Tltlbo/ParkingLotSystem/README.md

# 🚗 스마트 주차 관리 시스템 (Smart Parking Management System)

현대 사회의 심화되는 주차난과 주차장 이용의 불편함을 해소하기 위해 기획된 **스마트 주차 관리 시스템**입니다. 초음파 센서 기반의 주차 공간 감지, 2중 차단기 인터록(Interlock) 제어, 비상 인터폰 시스템 및 실시간 주차 위치 추천 알고리즘을 통합하여 효율적이고 안전한 주차 환경을 제공합니다.

 

## 👥 팀원 및 역할 분담 (Team Roles)
- **박진성 (팀장):** 주차 자리 감지 구현, UART 송수신 파이프라인 및 인터폰 기능 구현
- **박정환:** 서보 모터(Servo Motor) 차단기 구동 및 PWM 정밀 제어
- **전명준:** UART 수신 파이프라인 최적화 및 I2C 1602 LCD 상태 표시 UI 구현
- **정승헌:** 초음파 센서(HC-SR04) 구역 감지 및 알고리즘 구현

---

## 🛠 하드웨어 구성 및 핀 맵 (Hardware Setup & Pinmap)

본 프로젝트는 3개의 별도 STM32 보드를 사용하여 모듈화된 시스템을 구축했습니다. 각 보드 간에는 UART(921600 bps) 고속 통신을 사용하며, 통신 안정성을 위해 **Common GND**로 연결되어 있습니다.

### 1. InfoMark 보드 (상태 표시 및 정보 안내)
사용자에게 주차장 상태와 최적 주차 위치를 시각적으로 제공하는 보드입니다.
- **I2C1 (디스플레이 통신):** `PB8` (SCL), `PB9` (SDA)
- **USART1 (보드 간 통신):** `PA10` (RX), `PA9` (TX)
- **USART2 (디버그 통신):** `PA2` (TX), `PA3` (RX)

infomark_board_1788313444978

### 2. ParkingDetect 보드 (주차 자리 감지 및 메인 오디오 제어)
각 주차면의 상태를 아날로그 센서로 읽어들이고, 비상 인터폰용 오디오 입출력을 담당합니다.
- **ADC (주차면 아날로그 센서 입력):** `PA0`, `PA1`, `PA4`, `PA6`, `PA7`, `PB0`, `PC0`, `PC1`, `PC2`, `PC4`
- **I2S2 (INMP441 마이크 모듈):** `PB10` (CK/SCK), `PB12` (WS), `PC3` (SD)
- **PWM (LM386 오디오 앰프 출력):** `PA8` (TIM1_CH1)
- **USART1 (보드 간 통신):** `PA10` (RX), `PA9` (TX)

parkingdetect_board_1788313455689

### 3. plMachine 보드 (차단기 구동 및 출입구 초음파 감지)
주차장 진출입구의 통행량을 관리하고 차단기 모터를 제어합니다.
- **HC-SR04 초음파 센서 (입출차 감지):**
  - **TRIG (출력):** `PA6`, `PA7`, `PA8`, `PA9`
  - **ECHO (입력):** `PB10`, `PB13`, `PB14`, `PB15`
- **서보 모터 (차단기 제어):**
  - 입차 차단기 PWM: `PB8` (TIM4_CH3)
  - 출차 차단기 PWM: `PB9` (TIM4_CH4)

plmachine_board_1788313465761
---

## ✨ 주요 기능 (Key Features)

### 1. 단방향 2중 차단기 상호 인터록(Interlock) 제어
1차로와 같은 좁은 진출입로에서 발생할 수 있는 교행 사고를 물리적으로 원천 차단합니다.
- 입차 차량 진입 감지 시, 반대편 출차 차단기를 소프트웨어적으로 **강제 잠금(Lock)** 처리합니다.
- 차량이 완전히 통과하여 센서 점유가 해제된 후 정상 대기 모드로 복귀합니다.

### 2. 비상 인터폰 및 입출차 원격 제어
차단기 미인식 또는 돌발 상황 발생 시 관리실과 직접 소통할 수 있는 안전 메커니즘입니다.
- **양방향 통신:** 운전자가 비상 버튼을 누르면 INMP441(마이크)과 LM386(스피커)을 통해 관리실과 음성 교신을 진행합니다.
- **원격 해제:** 상황 확인 후 관리자 측에서 수동으로 인터록을 해제하고 차단기를 개방할 수 있습니다.

### 3. 실시간 주차 위치 추천 알고리즘
주차장 내 각 구역의 센싱 데이터를 바탕으로 운전자에게 최적의 주차 공간을 안내합니다.
- **실시간 센싱:** 10개 이상의 주차면에 배치된 센서가 주차 여부를 지속적으로 파악합니다.
- **최적 자리 계산:** 출입구 도보 5초 이내, 최단 거리 등의 조건부 우선순위에 따라 최우선 추천석을 결정합니다.
- **LED 표출:** 계산된 추천 구역(예: `[ B-01 ]`)을 I2C 패킷으로 전송하여 즉각 화면에 업데이트합니다.

---

## 기능 별 테스트 상황

| 정상 입출차 | 인터락 상황 |
| :---: | :---: |
|  |  |
| **마이크 및 차단봉 임의 조작** | **주차 감지** |
|  | 

## 🚀 트러블슈팅 (Troubleshooting)

개발 과정에서 마주친 주요 하드웨어 및 소프트웨어적 한계를 다음과 같이 극복했습니다. 상세한 과정은 [`troubleshooting.md`](troubleshooting.md)에서 확인할 수 있습니다.

1. **초음파 센서 간 상호 간섭 (Crosstalk) 해결**
   - **문제:** 여러 센서가 동시에 초음파를 발사하여 엉뚱한 거리(0cm 또는 300cm)로 값이 튀는 현상 발생.
   - **해결:** 데이터시트를 분석하여 트리거 주기를 기존 20ms에서 **60ms로 연장**하고, 센서들을 **순차적(폴링 방식)으로 측정**하도록 로직을 변경하여 잔여 음파로 인한 간섭을 제거했습니다.

2. **스피커 출력 노이즈 및 음질 개선**
   - **문제:** 마이크 오디오를 PWM으로 스피커에 직결 시 심한 노이즈 발생 및 스피커 코일 과부하 위험.
   - **해결:** 스피커 출력단에 **RC 로우패스 필터(Low-Pass Filter)**와 **커플링 커패시터(Coupling Capacitor)** 회로를 추가하여 고주파 노이즈를 걸러내고 DC 성분을 차단했습니다.

3. **오디오 지연 및 DMA 버퍼 오버런 (Baud Rate 병목)**
   - **문제:** 초당 32,000 Byte의 오디오 데이터를 115200 bps(초당 약 11,520 Byte)로 전송하려다 통신 지연 및 보드 멈춤 현상 발생.
   - **해결:** UART 통신 속도를 **921600 bps**로 대폭 상향하여 광활한 대역폭을 확보, 지연 없는 실시간 오디오 스트리밍을 구현했습니다.

4. **단일 UART 선에서 데이터 혼선 방지 (패킷 프로토콜 설계)**
   - **문제:** 하나의 통신 선으로 '텍스트(주차 상태)'와 '바이너리(오디오)' 데이터를 섞어서 보낼 때의 파싱 오류.
   - **해결:** 오디오 패킷 헤더로 우연히 발생할 확률이 극히 희박한 **`0xAA, 0x55`**를 채택했습니다. 주차 데이터는 전체 복구를 위한 `$PARK`(풀 스냅샷)와 즉각적인 반응을 위한 `$EVENT`(이벤트 알림) 패킷으로 분리하여 효율을 극대화했습니다.

---

## 🔮 향후 발전 방향 (Future Work)
- **비전 AI 연동:** 카메라 기반 차량 번호판 인식을 도입하여 비차량 오탐지 방지 및 자동 입출차 시스템 구현.
- **센서 퓨전 & 정교화:** 마이크 노이즈 필터링 고도화 및 다중 센서 값 융합을 통한 주차 감지 정확도 향상.
- **사용자 경험(UX) 개선:** 게이트 상태 및 경고 알림용 부저/인디케이터 추가 연동, 부드러운 모터 속도 제어(S-curve) 도입.
