Tltlbo/ParkingLotSystem/스마트 주차 차단기 발표 자료.pdf

# 스마트 주차 관리 시스템

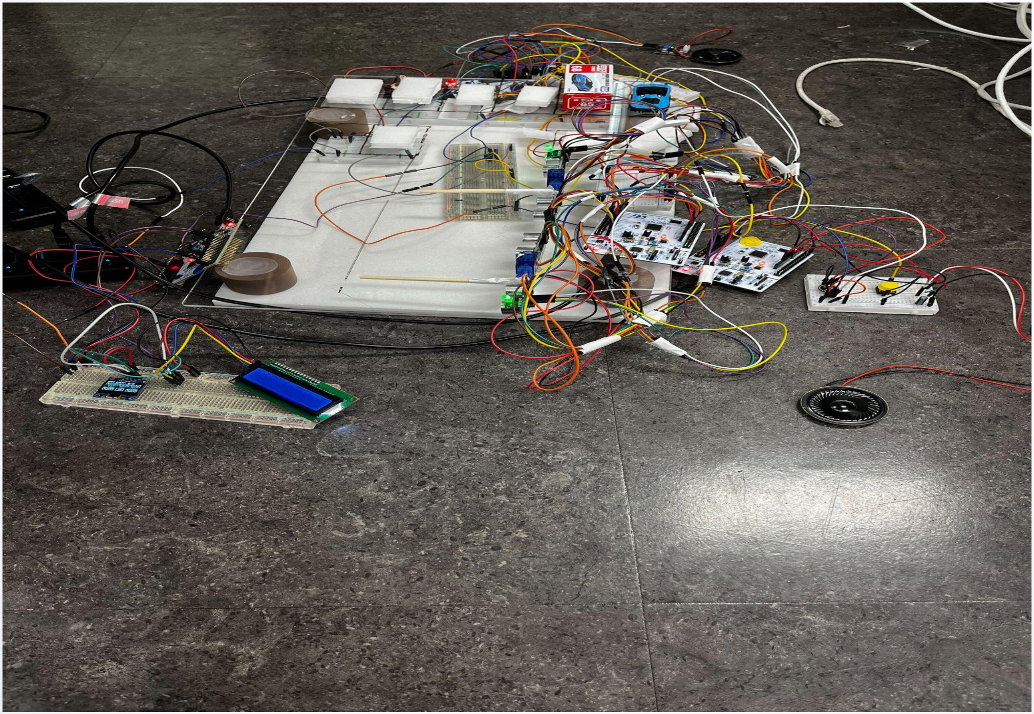
[picture p1: figure]

# 팀장 : 박진성 팀원 : 박정환 전명준 정승헌

# 주차장의 수요

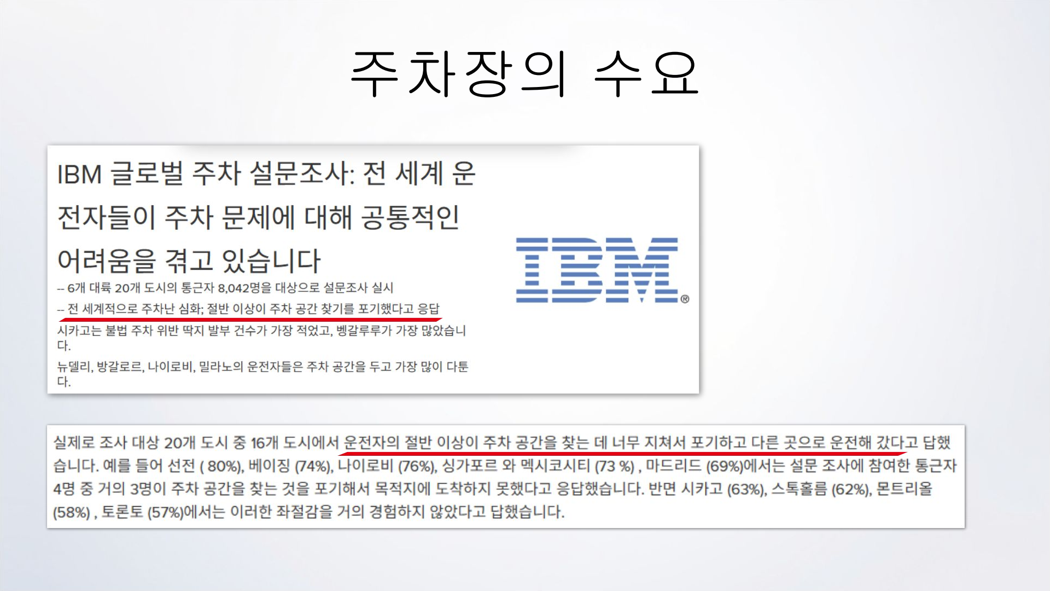
[picture p2: page 2]

# 기존 주차장들의 문제점

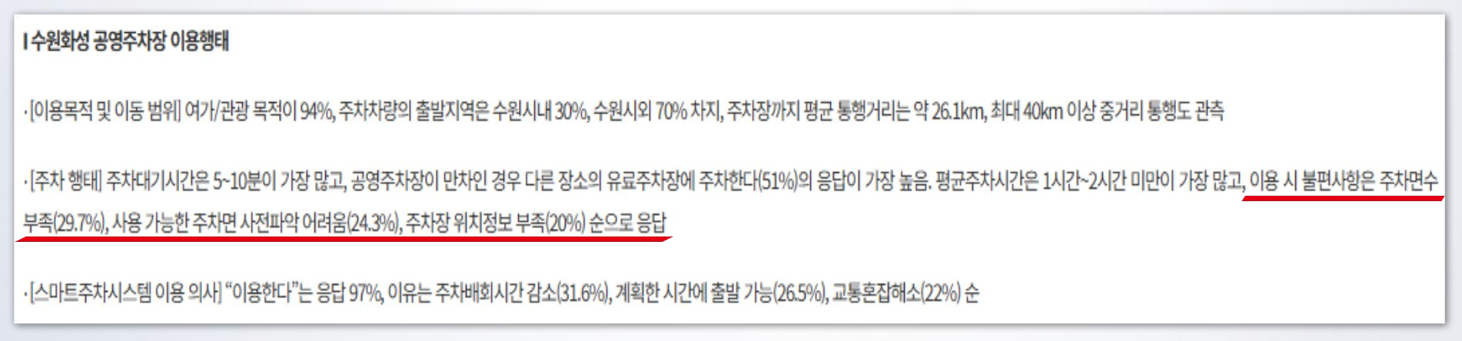
[picture p3: figure]

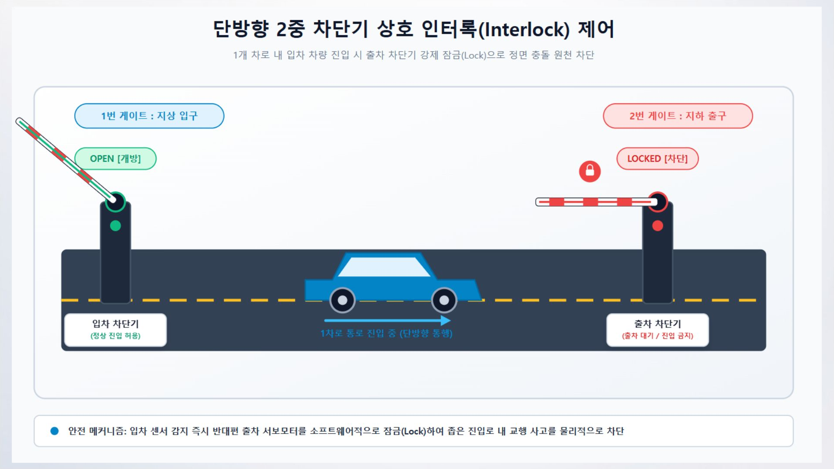
[picture p4: page 9]
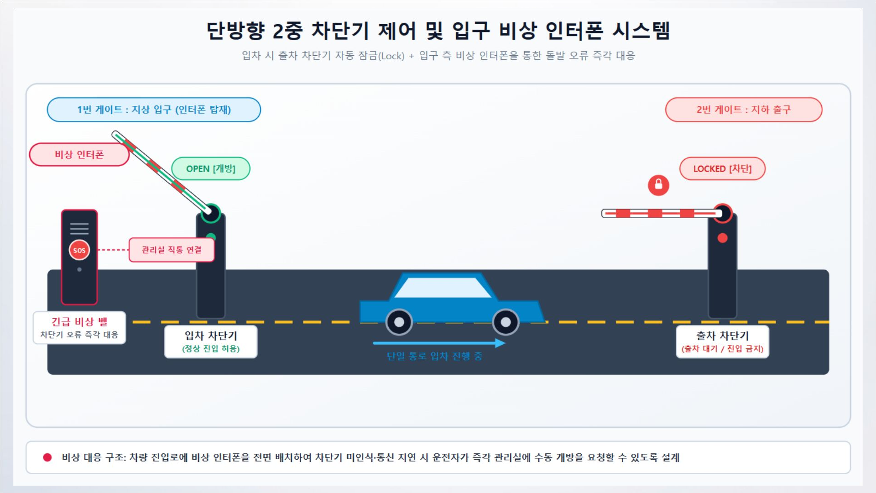
[picture p5: page 10]

# Team Role [팀원 역할

분담]

# 정승헌 : 초음파 센서 구역 감지 구현

# 박정환 : 서보 모터 차단기 구동 및 PWM 제어

# 전명준 : UART 수신 파이프라인 및 I2C 1602 LCD 상태 표시

# 박진성 : 주차 자리 감지 구현, UART 송신, 수신 및 인터폰

구현

# Servo Motor

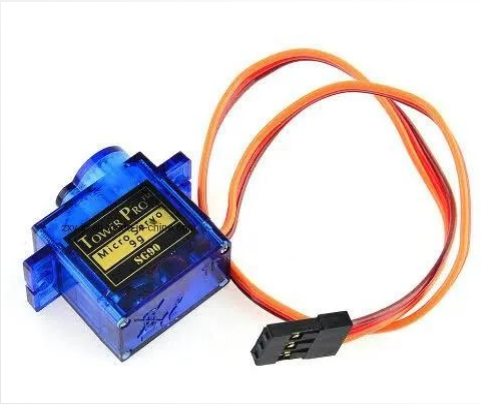
[picture p6: figure]

# - PWM

# 초음파 센서

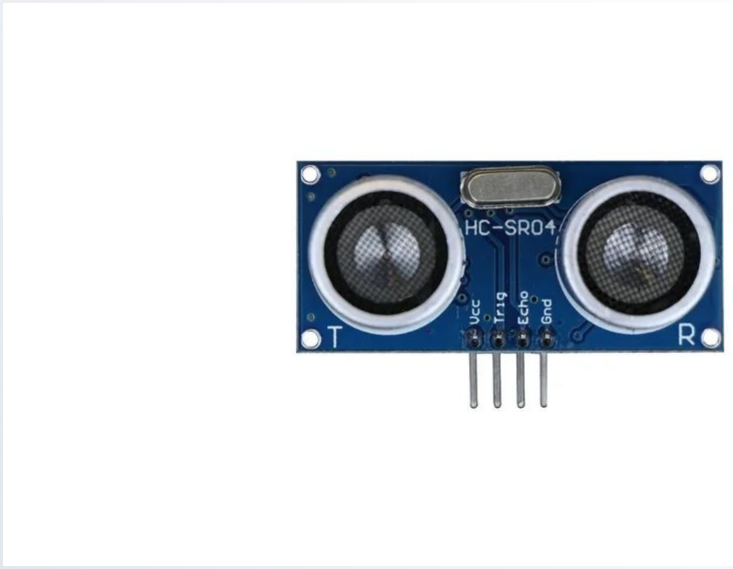
[picture p7: figure]

# - Echo

# - Trig

# INMP441 (마이크 모듈)

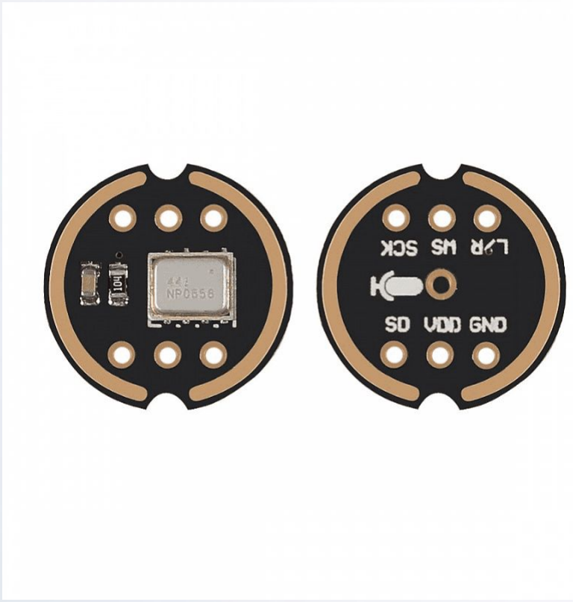
[picture p8: figure]

- I2S

# - SCK

- WS
- L/R
- SD

# - PCM

# LM386 (오디오 앰프 모듈)

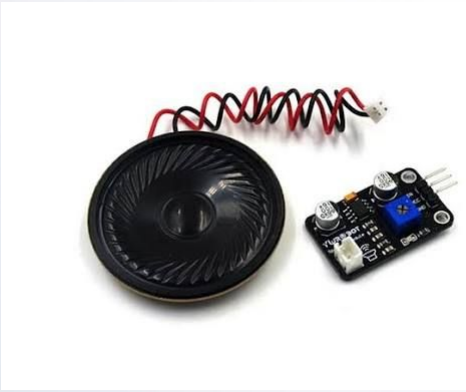
[picture p9: figure]

# - PWM

# 차단기 기능 모듈 배치

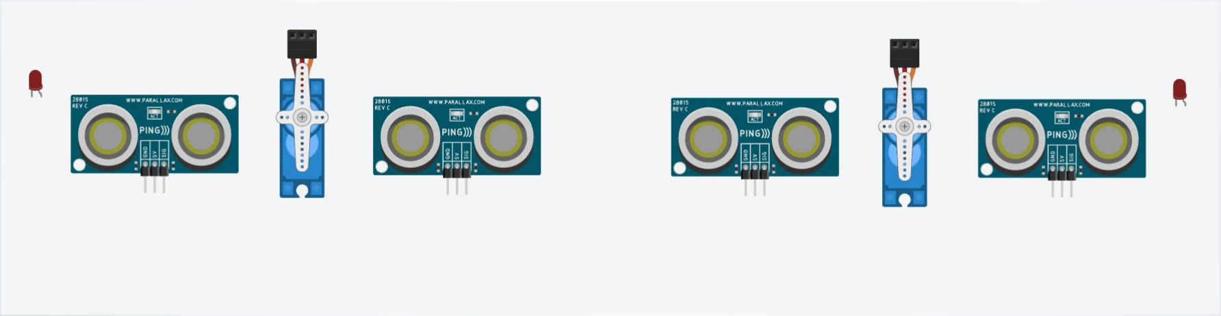
[picture p10: figure]

# 스마트 파킹 4개 초음파 센서 (HC-SR04) 주차차단기 제어 흐름도

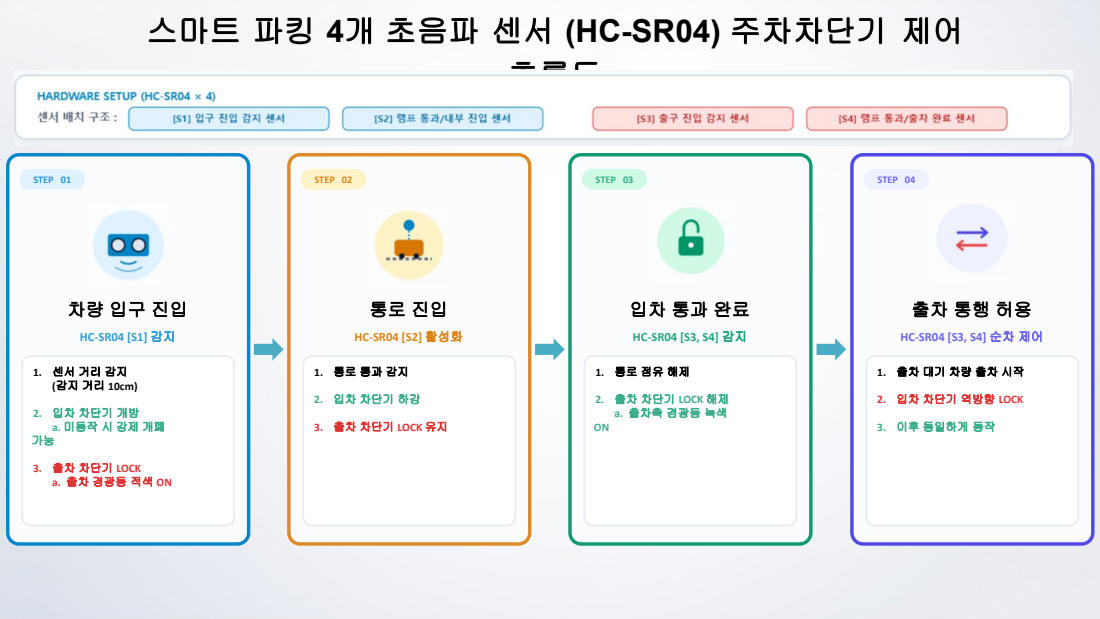
[picture p11: page 17]
STEP 01; STEP 04; STEP 02; HC-SR04 [S2] 활성화; STEP 03

2. 입차 차단기 하강

2. 출차 차단기 LOCK 해제
a. 출차측 경광등 녹색

2. 입차 차단기 역방향 LOCK

2. 입차 차단기 개방
a. 미동작 시 강제 개폐

3. 출차 차단기 LOCK 유지

3. 이후 동일하게 동작

3. 출차 차단기 LOCK
a. 출차 경광등 적색 ON

# 주차 감지 기능 모듈 배치

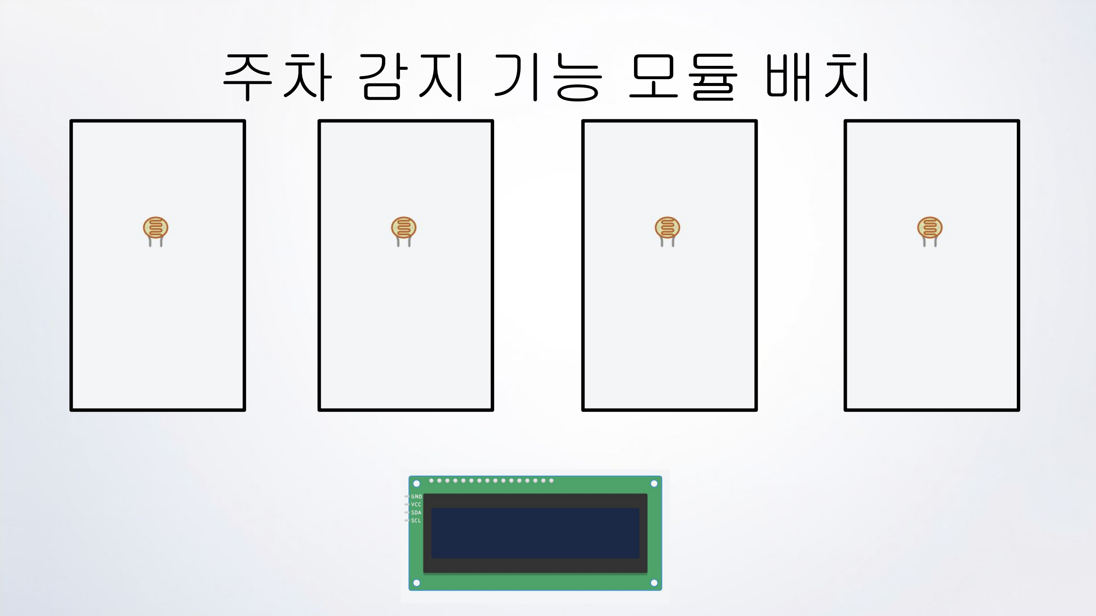
[picture p12: page 18]

# 주차 위치 추천 알고리즘 흐름도

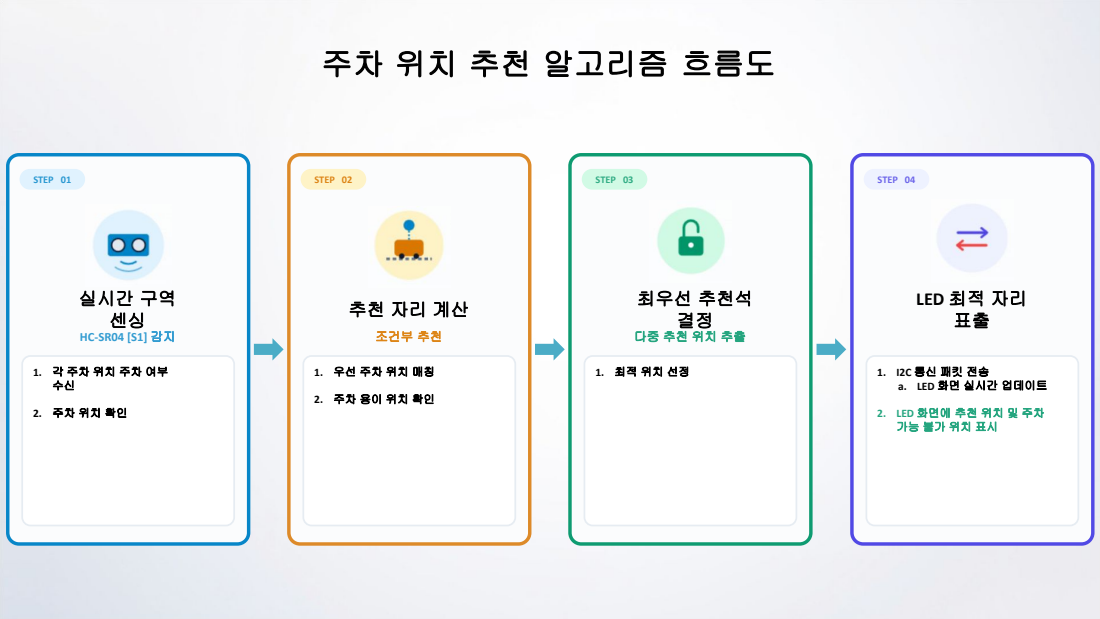
[picture p13: page 19]
STEP 01; 실시간 구역 센싱; STEP 04; STEP 02; 조건부 추천; STEP 03; 최우선 추천석 결정

LED 최적 자리

a. LED 화면 실시간 업데이트

2. LED 화면에 추천 위치 및 주차

# 비상 인터폰 모듈 배치

입차 측 | 출차 측

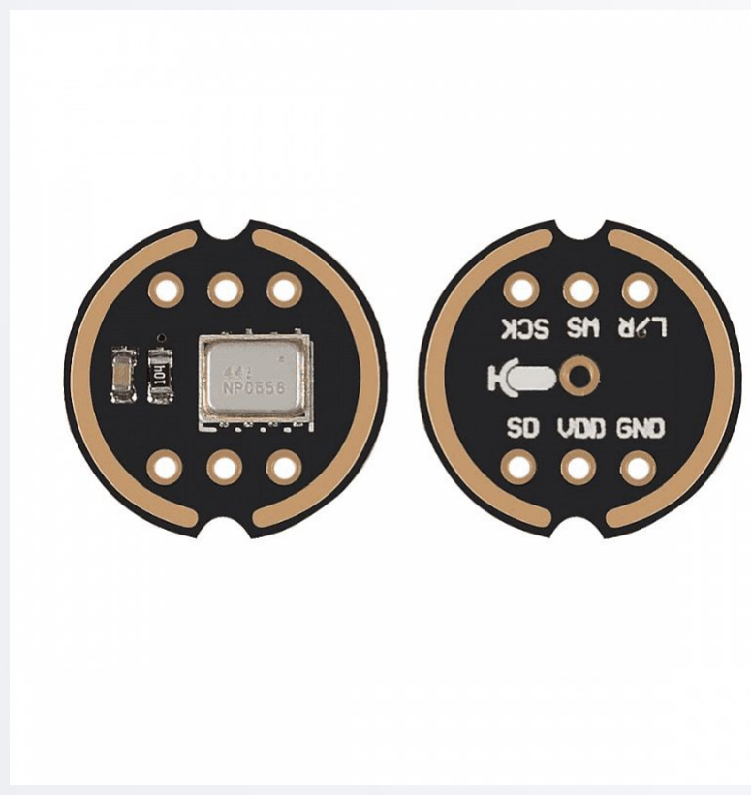
[picture p14: figure]
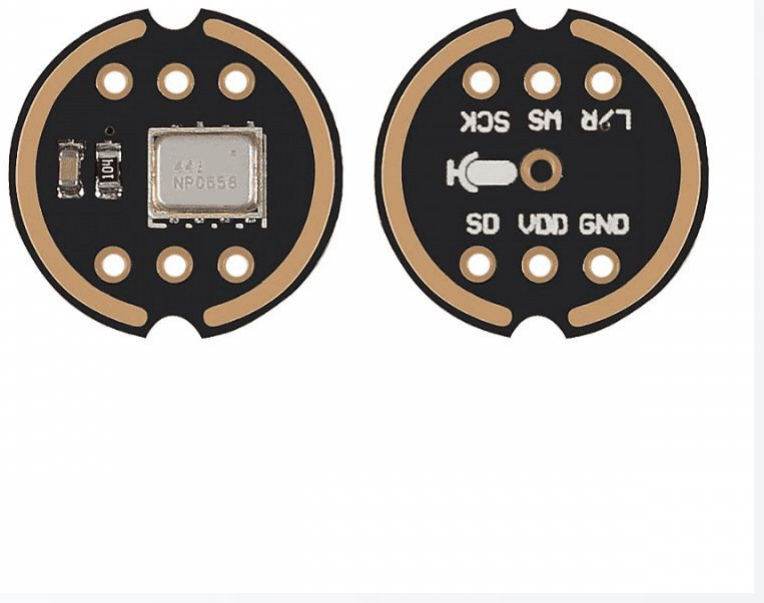
[picture p15: figure]
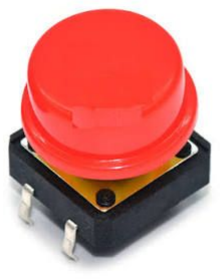
[picture p16: figure]
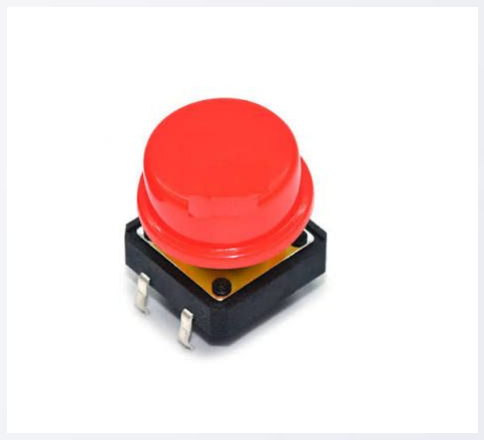
[picture p17: figure]
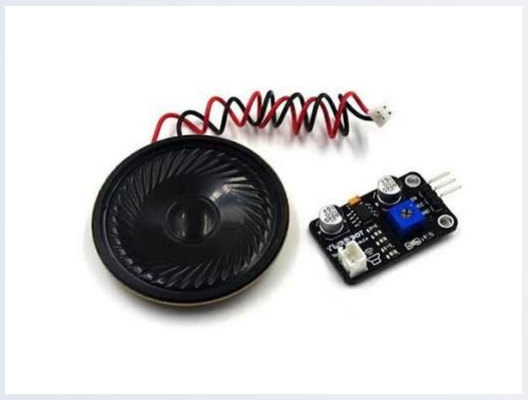
[picture p18: figure]
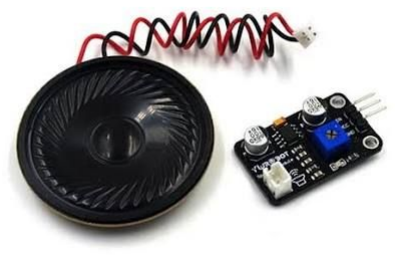
[picture p19: figure]

# 스마트 파킹 비상 인터폰 및 입출차 LOCK 해제 알고리즘

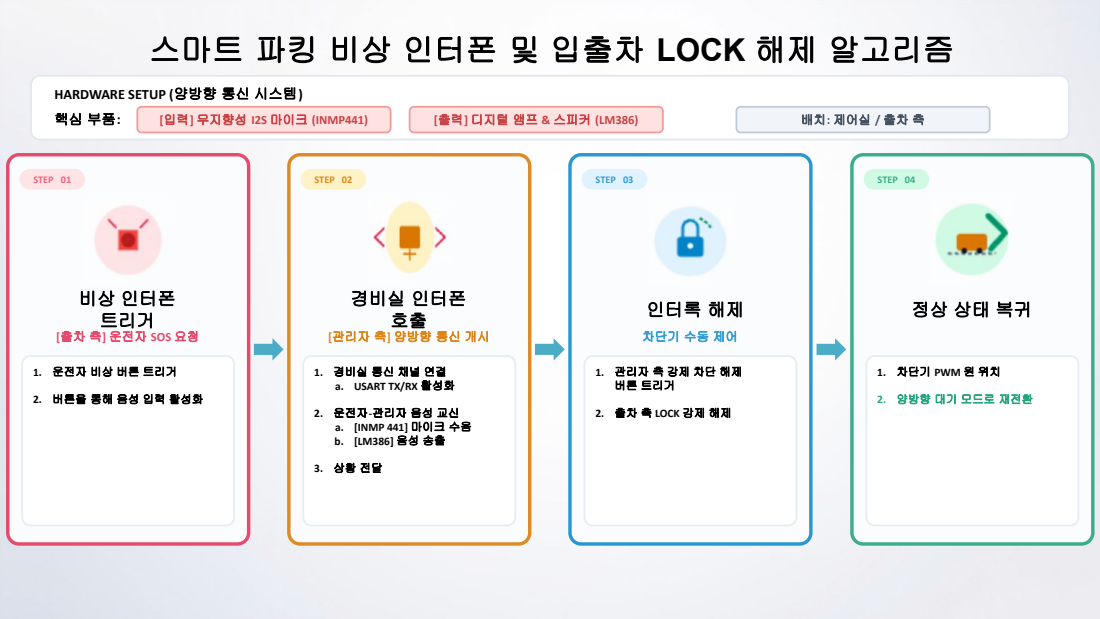
[picture p20: page 21]
STEP 01; 비상 인터폰 트리거; STEP 04; STEP 02; 경비실 인터폰 호출; STEP 03; 인터록 해제; [입력] 무지향성 I2S 마이크 (INMP441); [출력] 디지털 앰프 & 스피커 (LM386); 배치: 제어실 / 출차 측

HARDWARE SETUP (양방향 통신 시스템)

[출차 측] 운전자 SOS 요청

[관리자 측] 양방향 통신 개시

차단기 수동 제어

1. 운전자 비상 버튼 트리거

1. 경비실 통신 채널 연결
a. USART TX/RX 활성화

1. 관리자 측 강제 차단 해제
버튼 트리거

1. 차단기 PWM 원 위치

2. 버튼을 통해 음성 입력 활성화

2. 양방향 대기 모드로 재전환

2. 운전자-관리자 음성 교신
a. [INMP 441] 마이크 수음

2. 출차 측 LOCK 강제 해제

# 차단기 정상 동작

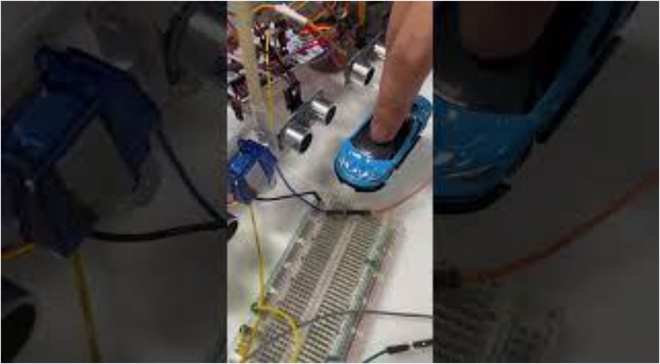
[picture p21: figure]

# 인터락 상황

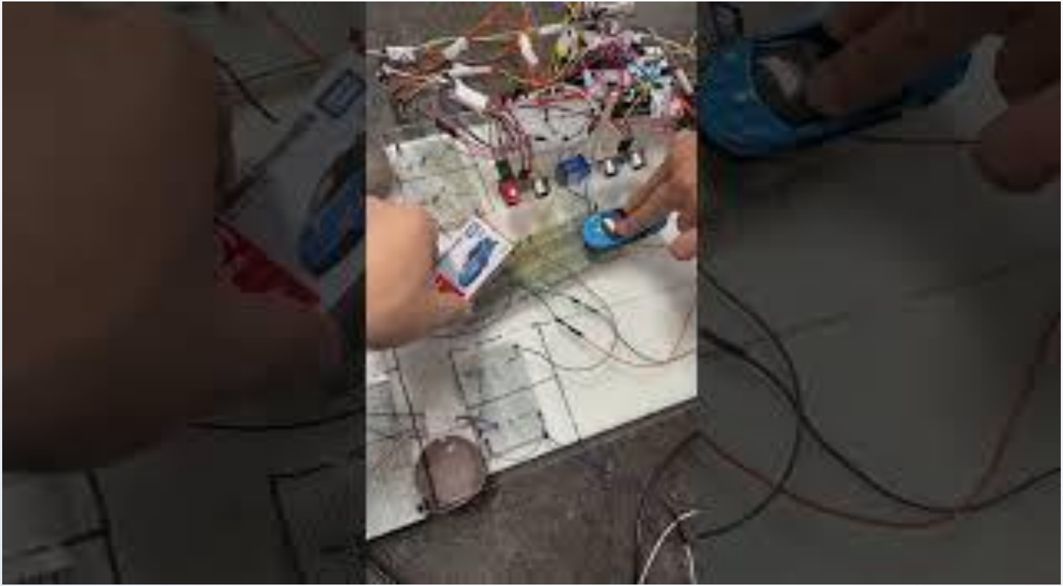
[picture p22: figure]

# 차단기 임의 개방

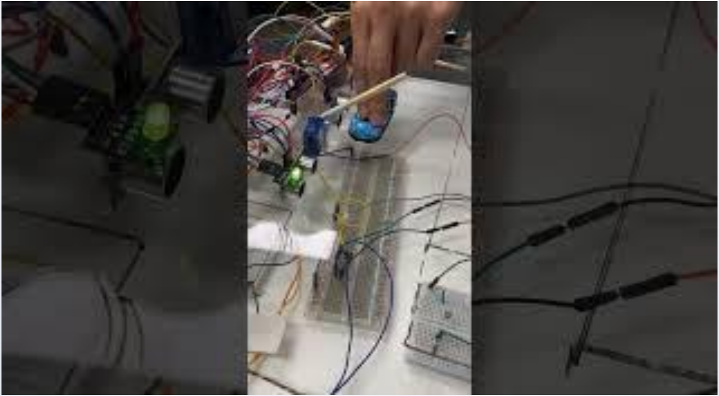
[picture p23: figure]

# 마이크 동작 및 차단기

동작

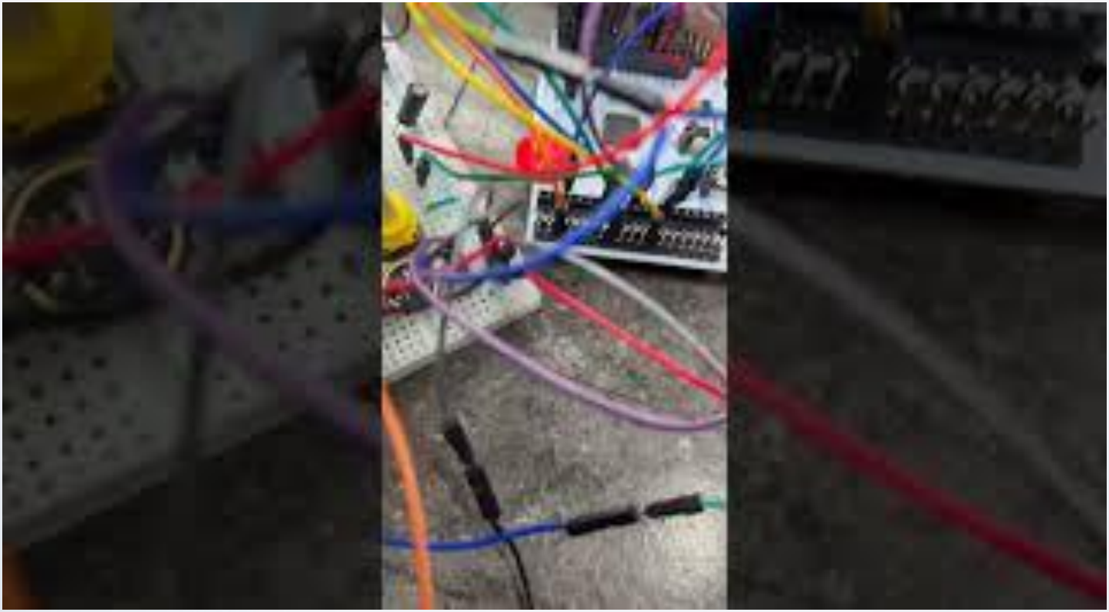
[picture p24: figure]

# 주차 감지

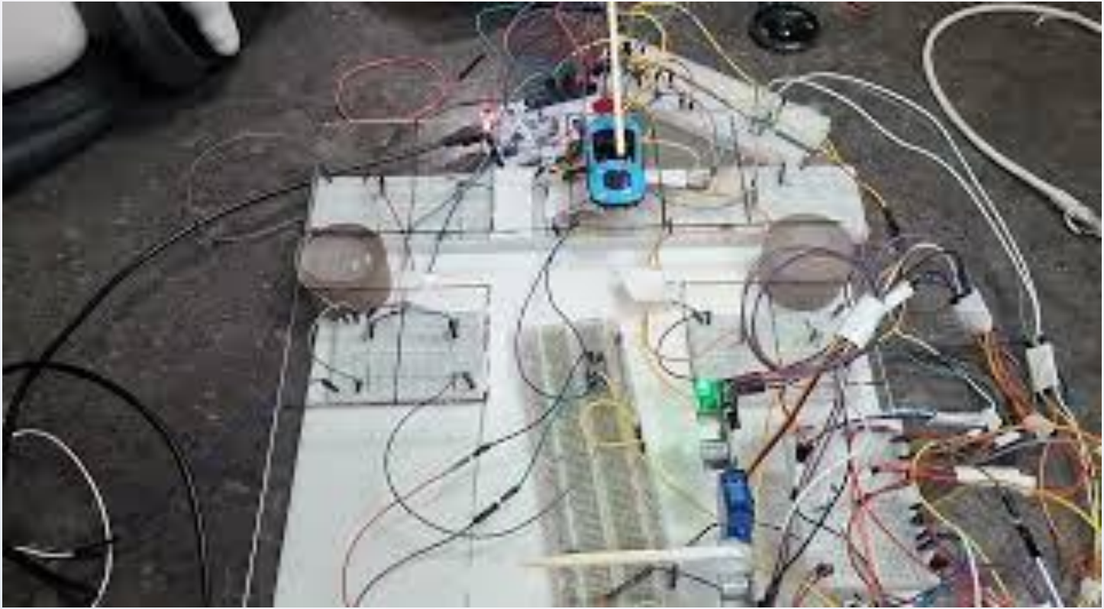
[picture p25: figure]

# 전체 동작

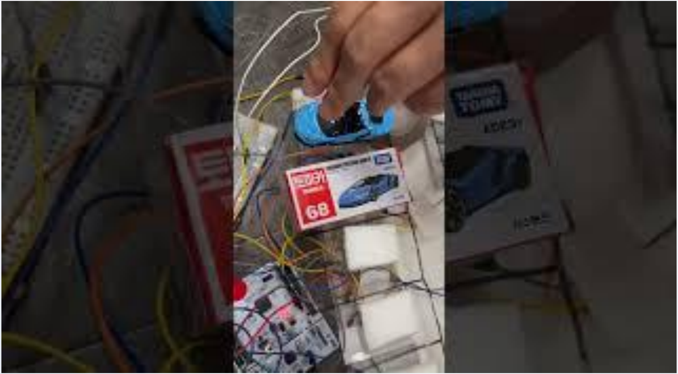
[picture p26: figure]

# 트러블 슈팅 [ 초음파 센서 인식 오류 ]

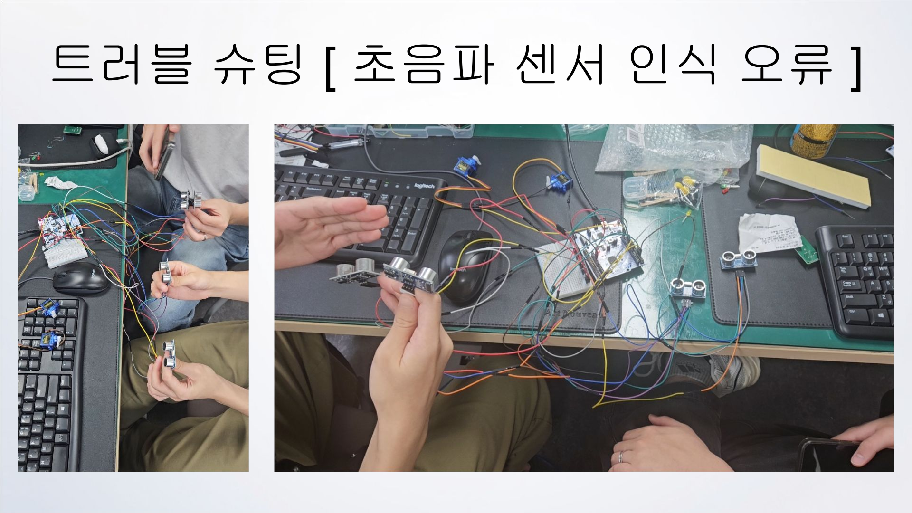
[picture p27: page 28]

# 센서 간 상호 간섭(Crosstalk)

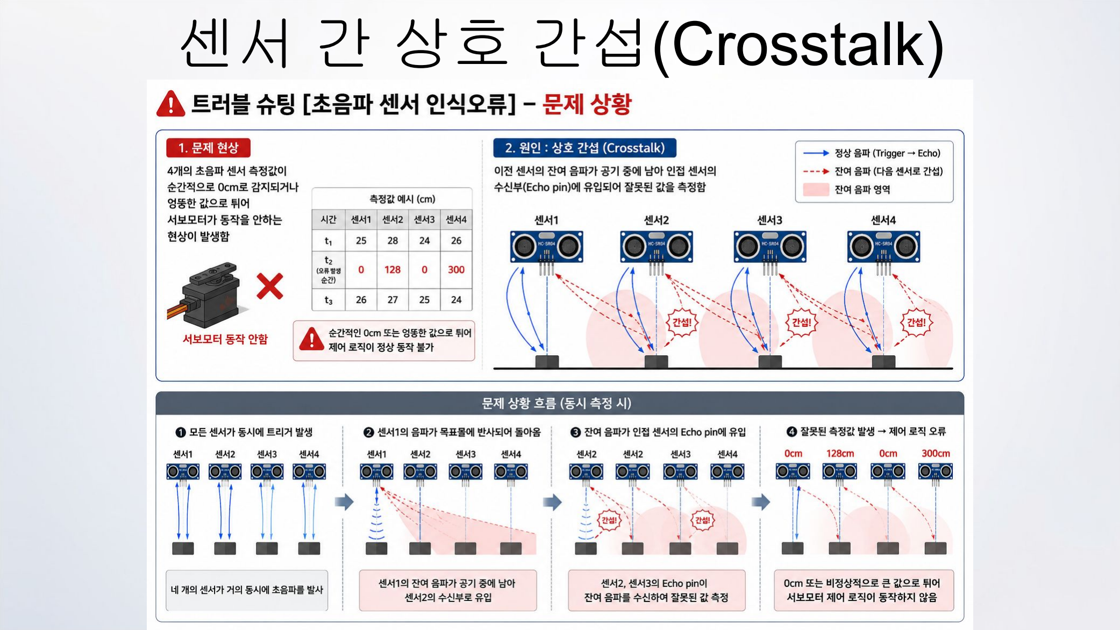
[picture p28: page 29]

# 상호 간섭 오류 개선

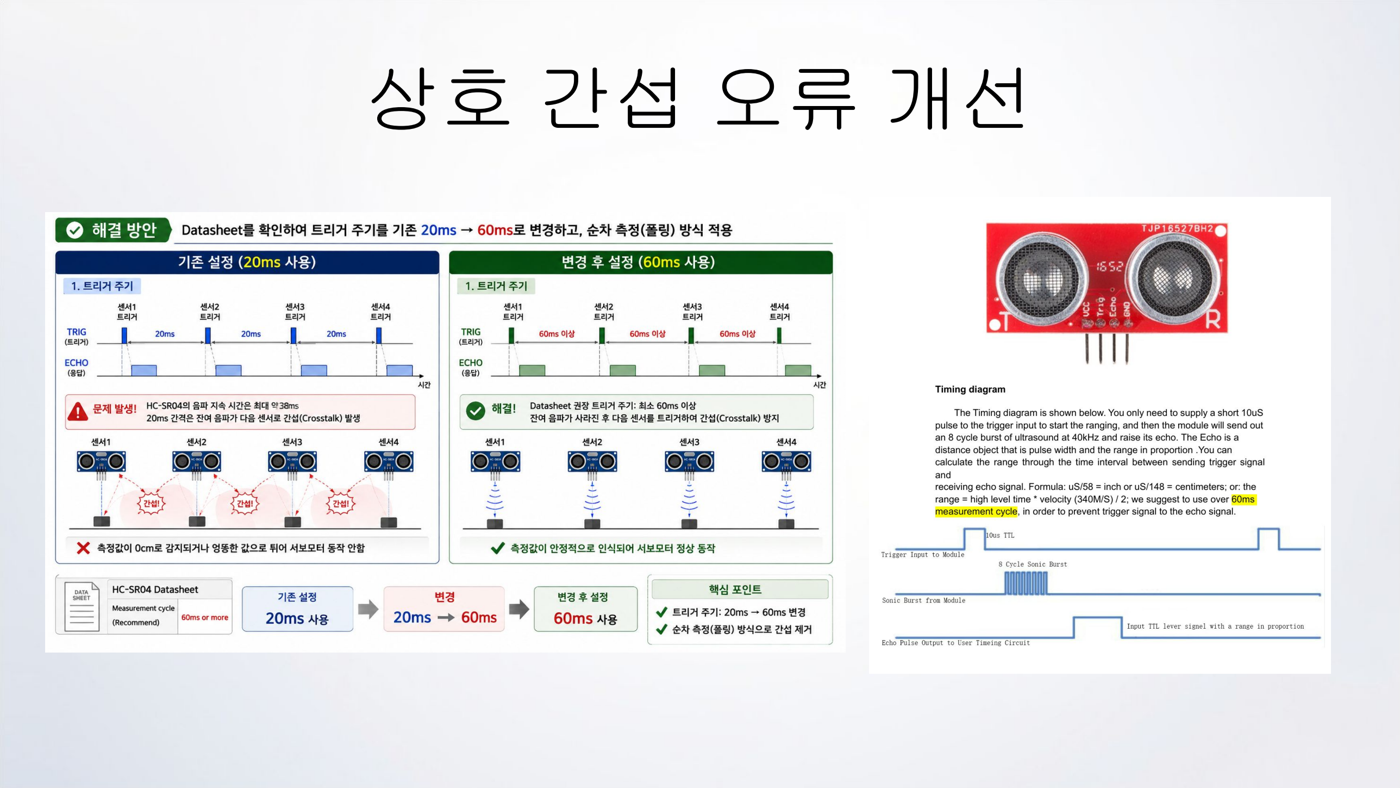
[picture p29: page 30]

# 트러블 슈팅 [스피커 출력 노이즈 오류 ]

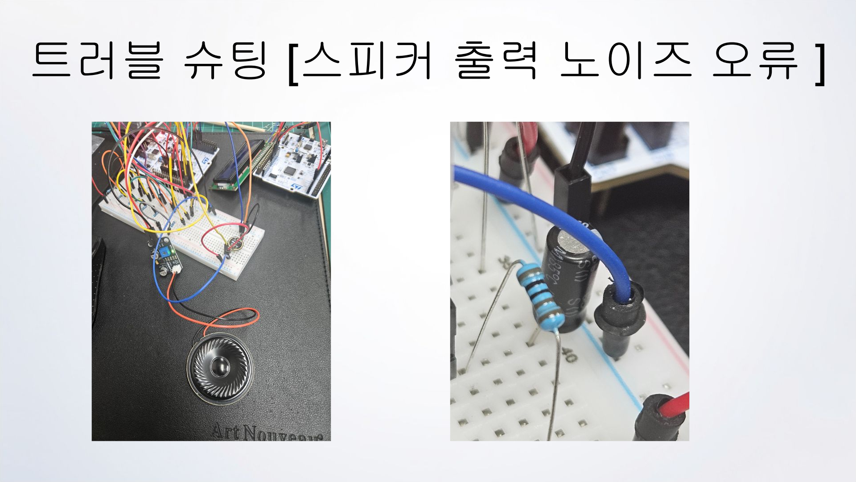
[picture p30: page 31]

# 문제 상황

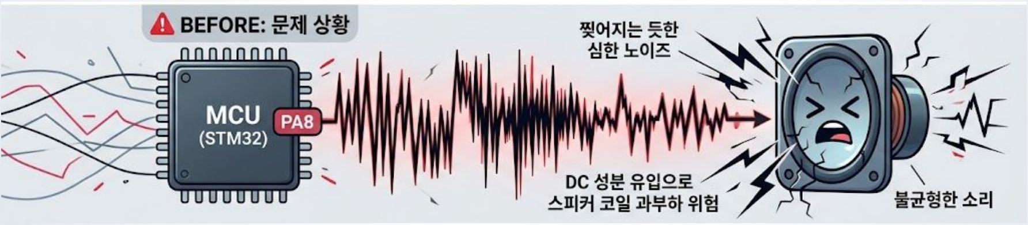
[picture p31: figure]

# 로우 패스 필터와 커플링 커패시터

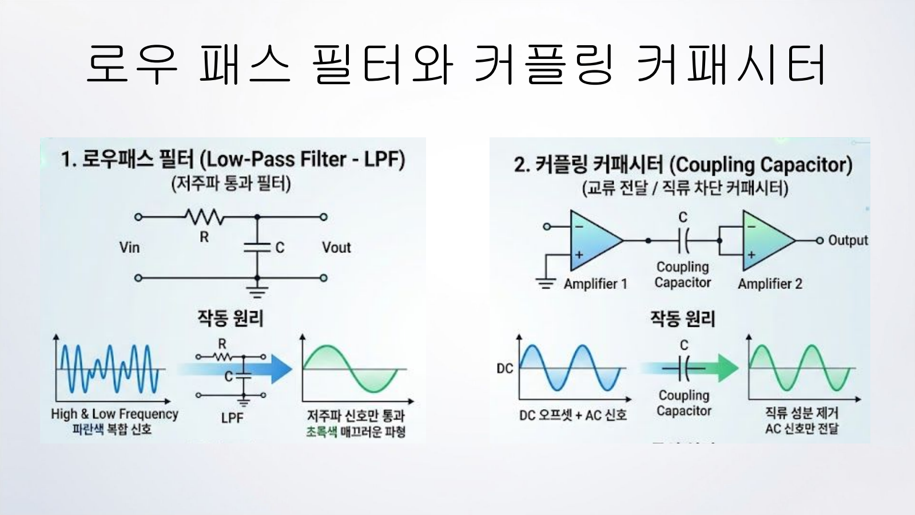
[picture p32: page 33]

# 트러블 슈팅 [오디오 지연]

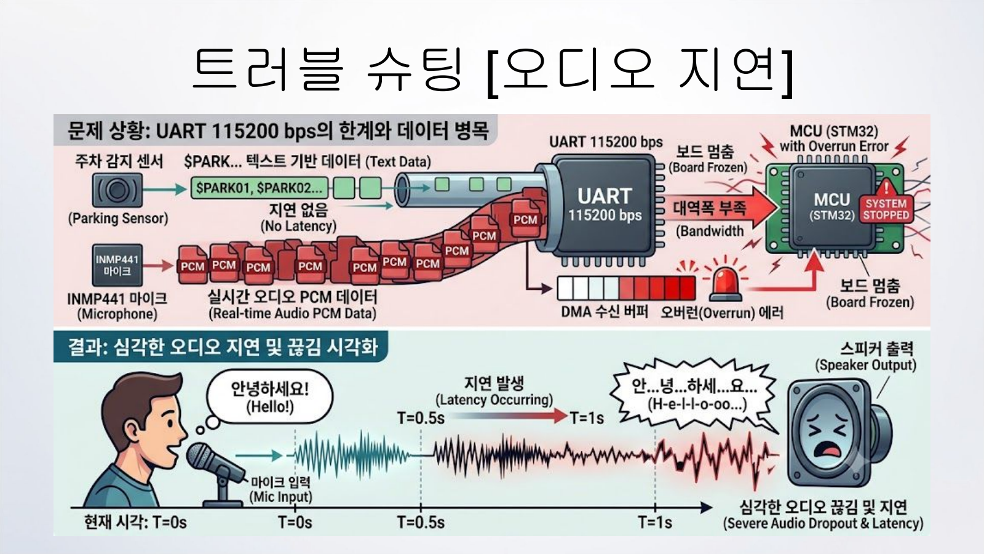
[picture p33: page 34]

# 왜 이런 문제가 발생할까?

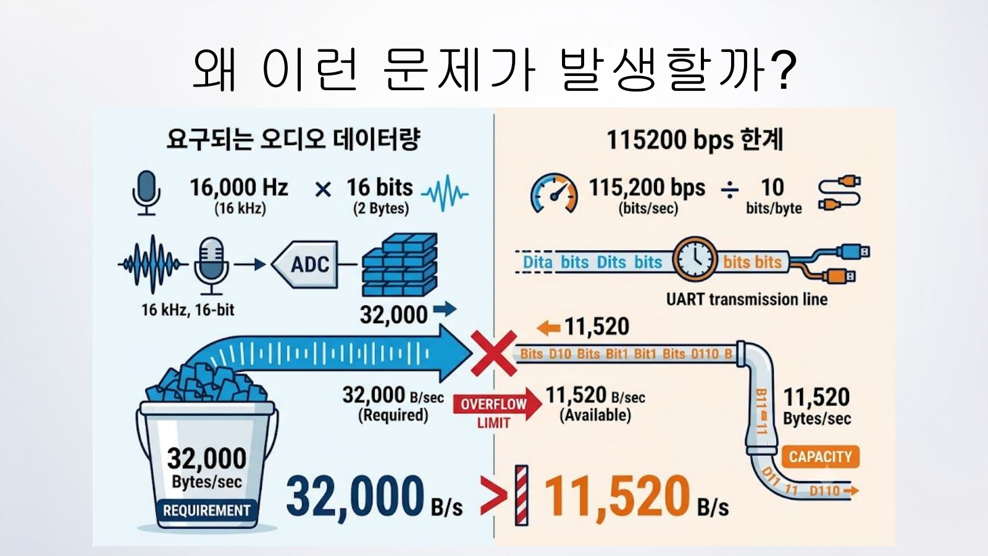
[picture p34: page 35]

# 트러블 슈팅 [동일한 UART 데이터 선

사용]

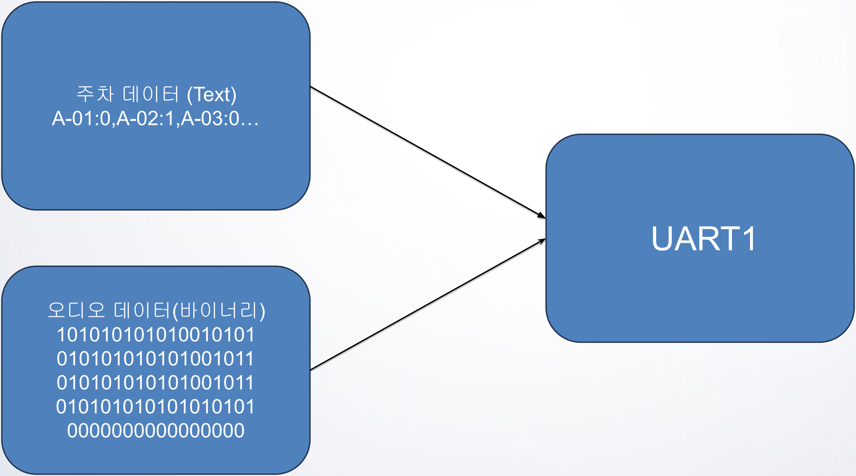
[picture p35: figure]
오디오 데이터(바이너리) 101010101010010101 010101010101001011 010101010101001011 010101010101010101 0000000000000000; 주차 데이터 (Text) A-01:0,A-02:1,A-03:0…; UART1

# 헤더의 사용

# 0xAA와 0x55

10101010
01010101

수학적으로 겹침 최소화 및 체크섬,

# payload 검증

# 헤더의 사용

# $PARK와 $EVENT

# 풀 스냅샷 이벤트 패킷

# 최초 실행 처리 및 복구 짧은 데이터로 지연 저하

# 1. 도움이 되었던 점 (배운 점)

# - 하드웨어 회로 지식: 커패시터 필터링을 통한 전원 노이즈 제거의 중요성 체감 - 데이터시트 기반 설계: HC-SR04 권장 주기(60ms) 분석 -> 잔향 감쇄 시간 확보로 센서 튐 현상 해결 - Git 형상 관리 및 모듈화: Merge 충돌 해결 경험을 통해 모듈 분리 필요성 체득

# 2. 아쉬웠던 점

# - 모터 속도 제어: 가감속(S-curve) 없는 즉시 각도 전환으로 기계적 충격 잔존 - 단일 센서 한계: 초음파 센서만으로는 보행자/장애물 등 비차량 오탐지 완벽 필터링

불가

# 3. 향후 발전 방향

# - 비전 AI 연동: 카메라 기반 차량 번호판 인식 -> 비차량 오탐지 방지 및 자동 입출차

구현

# - 센서 퓨전 & 정교화: 마이크 노이즈 필터링 및 다중 센서 값 융합을 통한 감지 정확도

향상

# - 사용자 피드백 추가: 게이트 상태 및 경고 알림용 부저/인디케이터 연동

Q & A

# 감사합니

다
