Tltlbo/ParkingLotSystem/plMachine/Core/Inc/main.h

#define TRIG_1_Pin GPIO_PIN_6
#define TRIG_1_GPIO_Port GPIOA
#define TRIG_2_Pin GPIO_PIN_7
#define TRIG_2_GPIO_Port GPIOA
#define ECHO_1_Pin GPIO_PIN_10
#define ECHO_1_GPIO_Port GPIOB
#define ECHO_4_Pin GPIO_PIN_13
#define ECHO_4_GPIO_Port GPIOB
#define ECHO_3_Pin GPIO_PIN_14
#define ECHO_3_GPIO_Port GPIOB
#define ECHO_2_Pin GPIO_PIN_15
#define ECHO_2_GPIO_Port GPIOB
#define TRIG_4_Pin GPIO_PIN_8
#define TRIG_4_GPIO_Port GPIOA
#define TRIG_3_Pin GPIO_PIN_9
#define TRIG_3_GPIO_Port GPIOA
#define TMS_Pin GPIO_PIN_13
#define TMS_GPIO_Port GPIOA
#define TCK_Pin GPIO_PIN_14
#define TCK_GPIO_Port GPIOA
