Tltlbo/ParkingLotSystem/ParkingDetect/MyApp/hw/driver/UARTTX.c

#include "UARTTX.h"
#include "usart.h"
#include "audioPass.h"
#include <stdio.h>
#include <string.h>

#define COMM_UART   huart1
#define DEBUG_UART  huart2

extern UART_HandleTypeDef COMM_UART;
extern UART_HandleTypeDef DEBUG_UART;

/* 오디오 프레임 송신용 전용 버퍼 (Ping-Pong 2개로 전송 덮어쓰기 방지) */
static uint8_t audio_frame_buf[2][AUDIO_PACKET_TOTAL];
static uint8_t frame_buf_idx = 0;

#define RX_DMA_BUF_SIZE (AUDIO_PACKET_TOTAL * 4) // 1KB+
static uint8_t rx_dma_buf[RX_DMA_BUF_SIZE];
static uint16_t rx_read_ptr = 0;

static uint8_t parse_state = 0;
static uint8_t parse_buf[AUDIO_PACKET_TOTAL];
static uint16_t parse_idx = 0;

#ifdef __GNUC__
int __io_putchar(int ch) {
    HAL_UART_Transmit(&DEBUG_UART, (uint8_t *)&ch, 1, 0xFFFF);
    return ch;
}
#endif

void commUartInit(void) {
    printf("[UART] Comm Module Initialized (Multiplexing Mode)\r\n");
    __HAL_UART_CLEAR_OREFLAG(&COMM_UART);
    __HAL_UART_CLEAR_FEFLAG(&COMM_UART);
    __HAL_UART_CLEAR_NEFLAG(&COMM_UART);
    // 원형 DMA 수신 시작 (중단 없이 계속 수신)
    HAL_UART_Receive_DMA(&COMM_UART, rx_dma_buf, RX_DMA_BUF_SIZE);
}

/* 바이너리 오디오 패킷 패킹 및 DMA 송신 */
void commUartSendAudioFrame(const int16_t *pcm_samples) {
    uint8_t *p_buf = audio_frame_buf[frame_buf_idx];
    frame_buf_idx = (frame_buf_idx + 1) % 2; // 다음 버퍼로 스위칭

    /* 1. 고유 프레임 헤더 (0xAA, 0x55) */
    p_buf[0] = 0xAA;
    p_buf[1] = 0x55;

    /* 2. Payload 길이 (256 바이트 -> 0x0100) */
    p_buf[2] = (uint8_t)(AUDIO_PAYLOAD_SIZE & 0xFF);
    p_buf[3] = (uint8_t)((AUDIO_PAYLOAD_SIZE >> 8) & 0xFF);

    /* 3. PCM 데이터 복사 */
    memcpy(&p_buf[4], (const uint8_t *)pcm_samples, AUDIO_PAYLOAD_SIZE);

    /* 4. 단순 체크섬(XOR) */
    uint8_t checksum = 0;
    for (int i = 0; i < 4 + AUDIO_PAYLOAD_SIZE; i++) {
        checksum ^= p_buf[i];
    }
    p_buf[4 + AUDIO_PAYLOAD_SIZE] = checksum;

    /* 5. Non-Blocking DMA 송신 (이전 송신 완료 상태일 때만) */
    if (COMM_UART.gState == HAL_UART_STATE_READY) {
        HAL_UART_Transmit_DMA(&COMM_UART, p_buf, AUDIO_PACKET_TOTAL);
    }
}

/* 주차 패킷 전송: 오디오 스트림 깨짐을 최소화하기 위해 논블로킹 체크 */
void commUartSendParkingStatus(void) {
    static char tx_buf[256];
    int offset = snprintf(tx_buf, sizeof(tx_buf), "$PARK");

    for (int i = 0; i < CDS_CHANNEL_COUNT; i++) {
        ParkingSlotID_t slot = (ParkingSlotID_t)i;
        offset += snprintf(tx_buf + offset, sizeof(tx_buf) - offset, ",%s:%d",
                           parkingGetSlotName(slot),
                           adcIsOccupied(slot) ? 1 : 0);
    }
    snprintf(tx_buf + offset, sizeof(tx_buf) - offset, "\n");

    /* 오디오 DMA 수신을 방해하지 않도록 논블로킹으로 전송 시도 */
    HAL_StatusTypeDef res = HAL_ERROR;
    if (COMM_UART.gState == HAL_UART_STATE_READY) {
        res = HAL_UART_Transmit(&COMM_UART, (uint8_t *)tx_buf, (uint16_t)strlen(tx_buf), 5);
    }

    /* UART1 전송 성공 여부 및 실제 전송된 패킷 콘솔 출력 */
    if (res == HAL_OK) {
        printf("[UART1 -> InfoMark] Sent OK (%d bytes):\r\n  >> %s\r\n", (int)strlen(tx_buf), tx_buf);
    } else {
        printf("[UART1 -> InfoMark] Send FAILED! (HAL Status: %d)\r\n", res);
    }
}

void commUartSendSlotEvent(ParkingSlotID_t slot, ParkingStatus_t status) {
    char tx_buf[64];
    snprintf(tx_buf, sizeof(tx_buf), "$EVENT,%s:%s\n",
             parkingGetSlotName(slot),
             (status == PARKING_OCCUPIED) ? "OCCUPIED" : "EMPTY");

    if (COMM_UART.gState == HAL_UART_STATE_READY) {
        HAL_UART_Transmit(&COMM_UART, (uint8_t *)tx_buf, (uint16_t)strlen(tx_buf), 5);
    }
}

static void commUartParseByte(uint8_t b) {
    if (parse_state == 0) {
        if (b == 0xAA) {
            parse_buf[0] = 0xAA;
            parse_idx = 1;
            parse_state = 1;
        }
    } else if (parse_state == 1) {
        if (b == 0x55) {
            parse_buf[1] = 0x55;
            parse_idx = 2;
            parse_state = 2;
        } else if (b == 0xAA) {
            parse_buf[0] = 0xAA;
            parse_idx = 1;
        } else {
            parse_state = 0;
        }
    } else if (parse_state == 2) {
        parse_buf[parse_idx++] = b;
        if (parse_idx == AUDIO_PACKET_TOTAL) {
            parse_state = 0;
            
            // 패킷 검증
            uint16_t len = parse_buf[2] | (parse_buf[3] << 8);
            if (len == AUDIO_PAYLOAD_SIZE) {
                uint8_t checksum = 0;
                for (int i = 0; i < 4 + AUDIO_PAYLOAD_SIZE; i++) {
                    checksum ^= parse_buf[i];
                }
                if (checksum == parse_buf[4 + AUDIO_PAYLOAD_SIZE]) {
                    // 유효한 오디오 패킷: 스피커 링버퍼로 푸시
                    audioPushToRingBuffer((const int16_t *)&parse_buf[4], AUDIO_FRAME_SAMPLES);
                }
            }
        }
    }
}

void commUartProcessRx(void) {
    // 현재 DMA가 어디까지 기록했는지 확인 (NDTR 레지스터 읽기)
    uint16_t write_ptr = (RX_DMA_BUF_SIZE - __HAL_DMA_GET_COUNTER(COMM_UART.hdmarx)) % RX_DMA_BUF_SIZE;
    
    while (rx_read_ptr != write_ptr) {
        uint8_t b = rx_dma_buf[rx_read_ptr];
        rx_read_ptr = (rx_read_ptr + 1) % RX_DMA_BUF_SIZE;
        commUartParseByte(b);
    }
}

void HAL_UART_ErrorCallback(UART_HandleTypeDef *huart) {
    if (huart->Instance == USART1) {
        __HAL_UART_CLEAR_OREFLAG(huart);
        __HAL_UART_CLEAR_FEFLAG(huart);
        __HAL_UART_CLEAR_NEFLAG(huart);
        // 에러 발생 시 DMA가 중단될 수 있으므로 재시작
        HAL_UART_Receive_DMA(huart, rx_dma_buf, RX_DMA_BUF_SIZE);
    }
}
