Tltlbo/ParkingLotSystem/(commit log)

2026-08-25 시작 환경 설정
2026-08-25 각 폴더 생성
2026-08-26 CI 설정
2026-08-26 CI 수정
2026-08-26 build: Update CMakeLists with MyApp driver paths and glob sources
2026-08-26 fix: CMake 설정 및 ioc 설정
    [ParkingDetect.ioc, main.c, main.h]
2026-08-26 hw: ioc 핀 활성화
2026-08-26 hw: 샘플링 시간 수정
    [ParkingDetect.ioc]
2026-08-26 hw: Generate initial CubeMX project with I2C1 and USART2
2026-08-26 feat: 주차 여부 감지 확인
2026-08-26 feat: UART TX 구현
2026-08-27 feat: TX 구현 및 감지에 따라 전송
2026-08-27 feat: Teleplot > LCD text 입력
2026-08-27 feat: 주차 여부 정보 파싱 및 lcd 표시 구현
2026-08-27 feat: 수음 확인
2026-08-27 fix: 수음에 따른 오출력
    [ParkingDetect.ioc, appMain.c, audioPass.c]
2026-08-27 feat: 수음 및 출력 성공
2026-08-28 feat: 버튼 활성화 시 수음 구현
2026-08-28 feat: UART 전송 구현
2026-08-28 fix: sensor-motor link
2026-08-28 fix: Add RGB LED warning indicator and fix SG90 PWM pulse configuration
    [apMain.c, main.c, main.h, myRgbLed.c, myRgbLed.h, mySg90.c, mySg90.h, plMachine.ioc]
2026-08-28 fix: 문자열 받는 크기 변경 및 timeout 수정 + 핀 확장
    [ParkingDetect.ioc, UARTTX.c, appMain.c, main.c, sensorADC.c, sensorADC.h]
2026-08-28 fix: 버튼 입력 시 수음 성공
    [appMain.c, audioPass.c, audioPass.h]
2026-08-28 feat: 양방향 통신 구현
2026-08-29 fix: support multi-vehicle continuous entry and exit logic
    [apMain.c, main.c, mySg90.c, mySg90.h, plMachine.ioc]
2026-08-29 feat: 주차여부 led 표시
2026-08-29 fix: 주차 감지 범위 설정
    [appMain.c, parkingDisplay.c, sensorADC.c]
2026-08-31 fix: 센서 측정 값 수정
    [appMain.c, sensorADC.c]
2026-08-31 fix: add S1 lock on manual entry and sync peripheral configuration
    [apMain.c, main.c, main.h, mySg90.c, plMachine.ioc]
2026-09-02 fix: CI 수정
2026-09-02 docs: 마크다운 작성
2026-09-02 docs: readme 수정
2026-09-02 docs: 테스트 영상 추가
    Added images and team roles section to README.
